ronron-gh/NUCLEO_F401RE_SIMPLE_OSCILLOSCOPE/doc/dev/SWdesign.md

# STM32 簡易オシロスコープ ソフトウェア設計

- [1. 簡易オシロスコープ仕様](#1-簡易オシロスコープ仕様)
- [2. 構成](#2-構成)
  - [2.1. ハードウェアブロック図](#21-ハードウェアブロック図)
  - [2.2. 開発環境](#22-開発環境)
  - [2.3. MCU仕様](#23-mcu仕様)
  - [2.4. MCUのピンアサイン](#24-mcuのピンアサイン)
- [3. サンプリング機能](#3-サンプリング機能)
- [4. 立ち上がりエッジトリガ機能](#4-立ち上がりエッジトリガ機能)
- [5. ディスプレイ表示機能](#5-ディスプレイ表示機能)
- [6. タッチパネル機能](#6-タッチパネル機能)
- [7. 起動画面](#7-起動画面)
  - [7.1. 起動画面データ格納の手順](#71-起動画面データ格納の手順)

## 1. 簡易オシロスコープ仕様

* チャンネル数 : 1ch　(立ち上がりエッジでトリガ可)
* 周波数帯域 : 40kHz
* A/D分解能 : 12bit
* サンプリング周波数 : 200kS/s
* レコード長 : 300サンプル
* 最高入力電圧 : 3.3V (分圧しない場合)

## 2. 構成
### 2.1. ハードウェアブロック図

### 2.2. 開発環境
* 開発用PC ・・・ OS: Windows10 64bit
* 統合開発環境 ・・・ STM32CubeIDE Version:1.8.0

### 2.3. MCU仕様
STM32 Nucleo Board STM32F401RE
* コアアーキテクチャ：ARM 32ビット Cortex-M4
* ピンアウト数：LQFP64
* 最高動作クロック：84MHz
* 内部メモリ：512KB(Flash)、96KB(SRAM)
* タイマー：16ビット多機能タイマx1、汎用タイマ×7
* 通信：SP1×3、I2Sx2、I2C×3、USART×3、USB-OTGx1、SDIOx1
* ADC：12ビットADC x1、10チャンネル
* GPIO数：50(5Vトレラント、一部を除く)
* 電源電圧：1.7~3.6V 

### 2.4. MCUのピンアサイン

■ Nucleo CN5 (digital)

| Pin | MCU pin | Function  | 用途 |
| --- | --- | --- | --- |
| D15 | PB8 | - | MSP2807　T_DO |
| D14 | PB9 | - | MSP2807　T_IRQ |
| GND | - | Ground | MSP2807　GND |
| D13 | PA5 | SPI1_SCK  | MSP2807　SCK |
| D12 | PA6 | SPI1_MISO | MSP2807　SDO(MISO) |
| D11 | PA7 | SPI1_MOSI | MSP2807　SDI(MOSI) |
| D10 | PB6 | - | MSP2807　CS |
| D9  | PC7 | - | MSP2807　DC/RS |
| D8  | PA9 | - | MSP2807　RESET |

■ Nucleo CN6 (power)

| Pin  | MCU pin | Function | 用途 |
| ---- | --- | --- | --- |
| +3V3 | - | 3.3V output | MSP2807　LED (バックライト) |
| +5V  | - | 5V output | MSP2807　VCC |

※バックライトはとりあえず3.3Vに接続しているが、GPIOに接続すればソフトウェアでバックライトをON/OFFできる。  

■ Nucleo CN8 (analog)  

| Pin | MCU pin | Function | 用途 |
| --- | --- | --- | --- |
| A0  | PA0 | ADC1_0 | 入力チャンネル |

■ Nucleo CN9

| Pin | MCU pin | Function | 用途 |
| --- | --- | --- | --- |
| D7  | PA8 | - | MSP2807　T_CLK |
| D6  | PB10 | TIM2_CH3 | テスト用信号(10kHz矩形波) |
| D5  | PB4 | TIM3_CH1 | - |
| D4  | PB5 | - | MSP2807　T_CS |
| D3  | PB3 | TIM2_CH2 | - |
| D2  | PA10 | - | MSP2807　T_DIN |

## 3. サンプリング機能
200kHzでAD変換し、ADデータをRAMに時系列に格納する機能。次の図のように、タイマ、ADC、DMAを連携させることで、ハードウェアのみでそのようなサンプリング機能を実現する。タイマー割り込みをトリガにしてAD変換を起動し、AD変換終了をトリガにしてDMAでADデータをRAMに転送する。

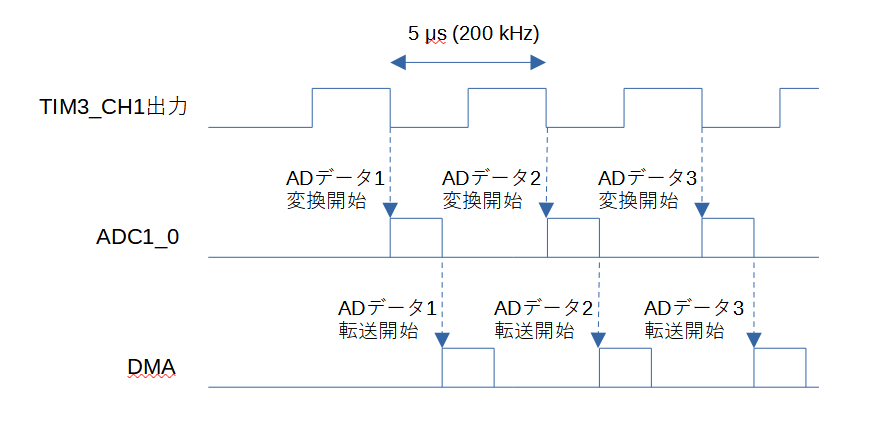
[picture p1: doc/dev/images/サンプリングの仕組み.png]


また、DMAをサーキュラモードにすることで、次の図のように、指定した転送数のメモリ転送を無限に繰り返す（繰り返しにより、先頭データから上書きされていく）。

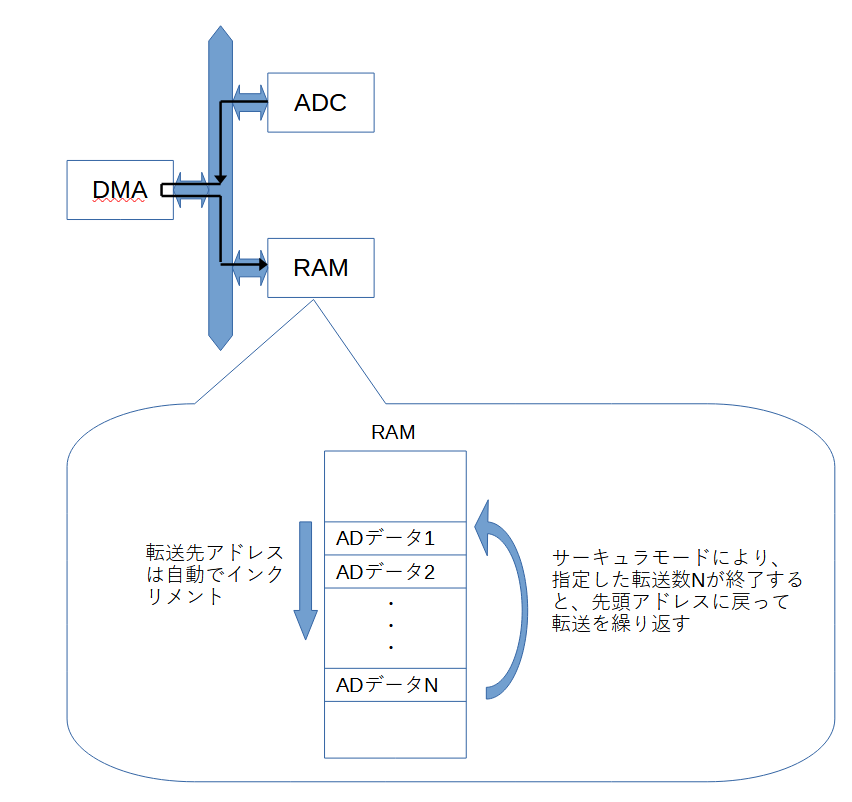
[picture p2: doc/dev/images/サンプリングの仕組み2.png]


## 4. 立ち上がりエッジトリガ機能
入力信号が閾値を超えたらサンプリングを停止する機能。次の図のように、ADCのアナログウォッチドッグ機能（AD変換結果が閾値を超えたら割り込みを発生）とタイマを利用して実現する。

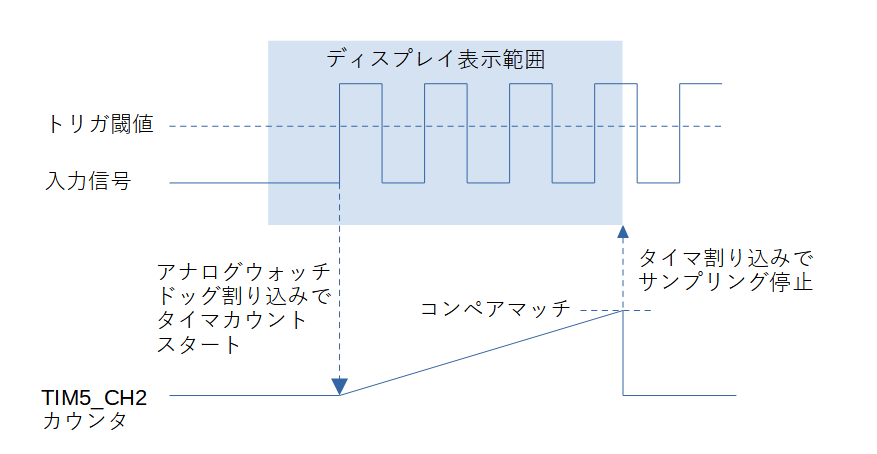
[picture p3: doc/dev/images/トリガの仕組み.png]


## 5. ディスプレイ表示機能
サンプリングデータをリアルタイム（10Hz程度）でディスプレイにグラフ表示する機能。MSP2807のインタフェースはSPIだが、MSP2807のサンプルプログラムをそのまま使うと、ソフトウェアで1ドットずつRGBデータをSPI送信データレジスタに書き込むため、ディスプレイの更新が非常に遅くなる。そのため、全体（320x240）のRGBデータを一旦RAM上で作成し、DMAでSPI送信データレジスタに転送するようにして高速化する。

## 6. タッチパネル機能
MSP2807のタッチパネルでオシロスコープの各種設定を行う機能。  
次の設定が可能。

* ms / div
* V / div
* トリガ機能 ON/OFF

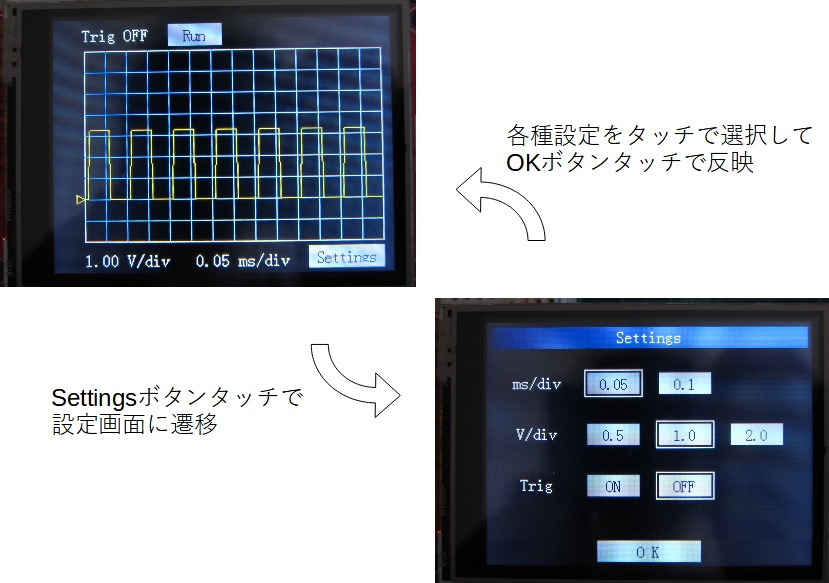
[picture p4: doc/dev/images/タッチパネル概要.jpg]


## 7. 起動画面
電源ON直後から3秒間、起動画面を表示する。起動画面データはフラッシュメモリに格納する（startup_screen.cでconst変数配列としてハードコーディング）。
### 7.1. 起動画面データ格納の手順
① 320x240 [pixel] のビットマップをstartup_screen.bmpというファイル名で作成する。

② 作成したビットマップをScriptフォルダに保存し、Scriptフォルダ内のstartup_screen_converter.py (Pythonスクリプト)を実行すると、output.txtがScriptフォルダ内に作成される。

③ output.txtの配列データをstartup.screen.cの配列 const u16 g_startup_screen[]の初期値としてコピー＆ペーストする。

```c
const u16 g_startup_screen[LCD_BUF_SIZE] = {
    この中にoutput.txt内の配列データをコピペ
}
```
