ronron-gh/NUCLEO_F401RE_SIMPLE_OSCILLOSCOPE/doc/dev/images/175___05/IMG_3227.JPG

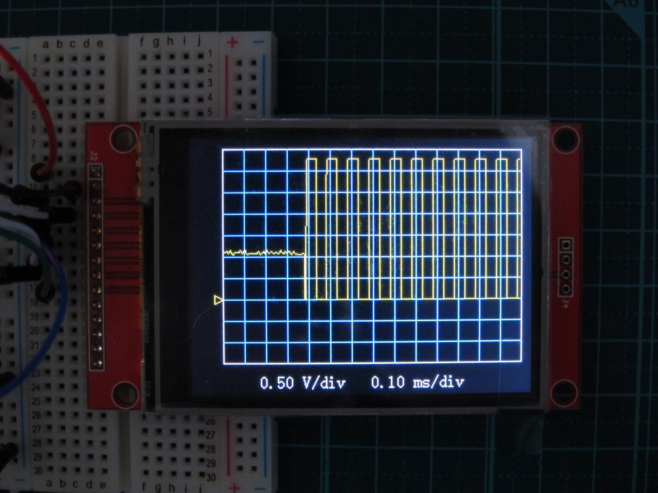
doc/dev/images/175___05/IMG_3227.JPG
