ronron-gh/NUCLEO_F401RE_SIMPLE_OSCILLOSCOPE/doc/dev/images/176___06/IMG_3230.JPG

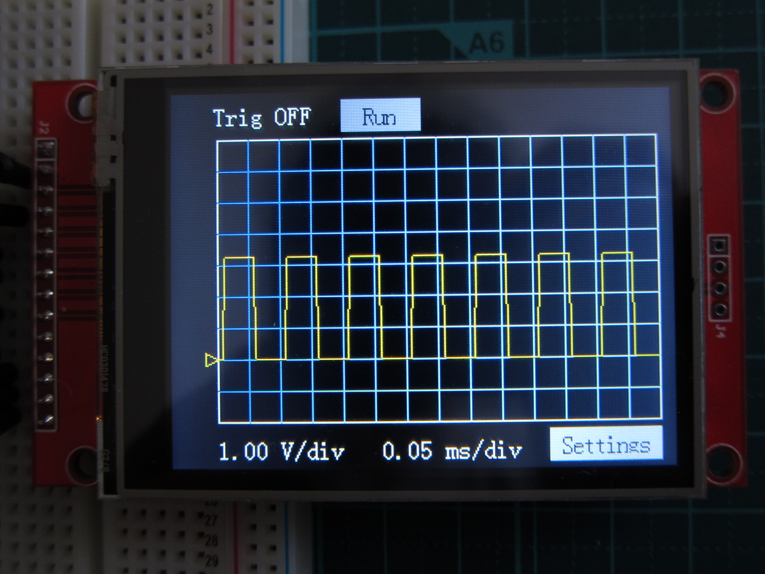
doc/dev/images/176___06/IMG_3230.JPG
