ronron-gh/NUCLEO_F401RE_SIMPLE_OSCILLOSCOPE/doc/dev/images/176___06/IMG_3231.JPG

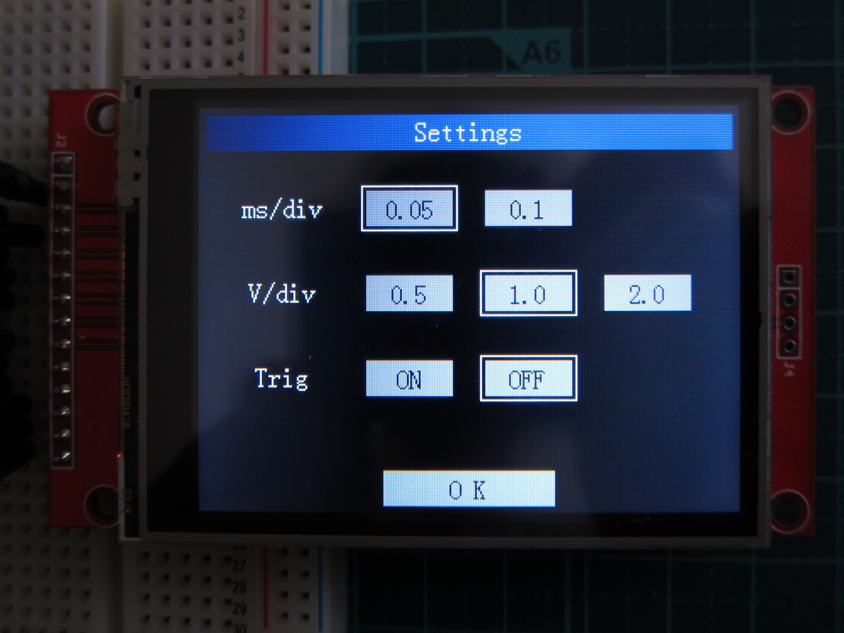
doc/dev/images/176___06/IMG_3231.JPG
