ronron-gh/NUCLEO_F401RE_SIMPLE_OSCILLOSCOPE/Core/Src/main.c

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
/* Includes ------------------------------------------------------------------*/
#include "main.h"

/* USER CODE BEGIN Includes */
#include "stdio.h"
#include "string.h"
#include "math.h"
#include "lcd.h"
#include "lcd2.h"
#include "GUI.h"
#include "Touch.h"
#include "Oscillo.h"
#include "test.h"
/* USER CODE END Includes */

ADC_HandleTypeDef hadc1;
DMA_HandleTypeDef hdma_adc1;

SPI_HandleTypeDef hspi1;
DMA_HandleTypeDef hdma_spi1_tx;

TIM_HandleTypeDef htim2;
TIM_HandleTypeDef htim3;
TIM_HandleTypeDef htim5;

UART_HandleTypeDef huart2;

void SystemClock_Config(void);
static void MX_GPIO_Init(void);
static void MX_USART2_UART_Init(void);
static void MX_SPI1_Init(void);
static void MX_DMA_Init(void);
static void MX_ADC1_Init(void);
static void MX_TIM2_Init(void);
static void MX_TIM3_Init(void);
static void MX_TIM5_Init(void);
/**
  * @brief  The application entry point.
  * @retval int
  */
int main(void)
{
  /* MCU Configuration--------------------------------------------------------*/

  /* Reset of all peripherals, Initializes the Flash interface and the Systick. */
  HAL_Init();

  /* Configure the system clock */
  SystemClock_Config();

  /* Initialize all configured peripherals */
  MX_GPIO_Init();
  MX_USART2_UART_Init();
  MX_DMA_Init();
  MX_SPI1_Init();
  MX_ADC1_Init();
  MX_TIM2_Init();
  MX_TIM3_Init();
  MX_TIM5_Init();
  /* USER CODE BEGIN 2 */
  // !!!Note!!! Modify the auto-generated code to call MX_DMA_Init() before MX_SPI1_Init() in order to use DMA in SPI1

  /* USER CODE END 2 */

  /* Infinite loop */
  /* USER CODE BEGIN WHILE */
  LCD_Init();
  HAL_Delay(3000);
  TP_Init();
  oscillo_init();

  while (1)
  {
#ifndef TOUCH_TEST_MODE
    HAL_Delay(100);
    oscillo_draw(current_view);

#else
	// Touch test
	Touch_Test();
#endif


#if 0	// ADC test
    {
      uint32_t adc_dr;

      HAL_ADC_Start(&hadc1);
	  HAL_ADC_PollForConversion(&hadc1, 1000);
	  adc_dr = HAL_ADC_GetValue(&hadc1);
	  //adc_phy = adc_dr * 3.3 / 4096;
	  printf("adc result: %ld\n", adc_dr);
    }
#endif

#if 0	// LCD test
	  //main_test();
	  	Test_Color();
		Test_FillRec();
		Test_Circle();
		Test_Triangle();
#endif

    /* USER CODE END WHILE */

    /* USER CODE BEGIN 3 */
  }
  /* USER CODE END 3 */
}

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
/* USER CODE BEGIN 4 */
int _write(int file, char *ptr, int len)
{
  int DataIdx;
  for(DataIdx=0; DataIdx<len; DataIdx++)
  {
    ITM_SendChar(*ptr++);
  }
  return len;
}



/* USER CODE END 4 */
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
