ronron-gh/NUCLEO_F401RE_SIMPLE_OSCILLOSCOPE/Core/Inc/main.h

#define LCD_DIRECTION	(1)		// 0:0deg 1:90deg 2:180deg 3:270deg
#define TRUE	(1)
#define FALSE	(0)
#define B1_Pin GPIO_PIN_13
#define B1_GPIO_Port GPIOC
#define B1_EXTI_IRQn EXTI15_10_IRQn
#define USART_TX_Pin GPIO_PIN_2
#define USART_TX_GPIO_Port GPIOA
#define USART_RX_Pin GPIO_PIN_3
#define USART_RX_GPIO_Port GPIOA
#define LCD_RS_Pin GPIO_PIN_7
#define LCD_RS_GPIO_Port GPIOC
#define T_CLK_Pin GPIO_PIN_8
#define T_CLK_GPIO_Port GPIOA
#define LCD_RESET_Pin GPIO_PIN_9
#define LCD_RESET_GPIO_Port GPIOA
#define T_DIN_Pin GPIO_PIN_10
#define T_DIN_GPIO_Port GPIOA
#define TMS_Pin GPIO_PIN_13
#define TMS_GPIO_Port GPIOA
#define TCK_Pin GPIO_PIN_14
#define TCK_GPIO_Port GPIOA
#define SWO_Pin GPIO_PIN_3
#define SWO_GPIO_Port GPIOB
#define T_CS_Pin GPIO_PIN_5
#define T_CS_GPIO_Port GPIOB
#define SPI1_CS_Pin GPIO_PIN_6
#define SPI1_CS_GPIO_Port GPIOB
#define T_DO_Pin GPIO_PIN_8
#define T_DO_GPIO_Port GPIOB
#define T_IRQ_Pin GPIO_PIN_9
#define T_IRQ_GPIO_Port GPIOB
#define T_IRQ_EXTI_IRQn EXTI9_5_IRQn
