ronron-gh/NUCLEO_F401RE_SIMPLE_OSCILLOSCOPE/Lcd/lcd.h

//////////////////////////////////////////////////////////////////////////////////	 

















//All rights reserved
/****************************************************************************************************
























**************************************************************************************************/		
 /* @attention
  *
  * THE PRESENT FIRMWARE WHICH IS FOR GUIDANCE ONLY AIMS AT PROVIDING CUSTOMERS
  * WITH CODING INFORMATION REGARDING THEIR PRODUCTS IN ORDER FOR THEM TO SAVE
  * TIME. AS A RESULT, QD electronic SHALL NOT BE HELD LIABLE FOR ANY
  * DIRECT, INDIRECT OR CONSEQUENTIAL DAMAGES WITH RESPECT TO ANY CLAIMS ARISING
  * FROM THE CONTENT OF SUCH FIRMWARE AND/OR THE USE MADE BY CUSTOMERS OF THE
  * CODING INFORMATION CONTAINED HEREIN IN CONNECTION WITH THEIR PRODUCTS.
**************************************************************************************************/	
#ifndef __LCD_H
#define __LCD_H		
//#include "sys.h"
#include "stdlib.h"
#include "main.h"



typedef struct  
{										    
	u16 width;
	u16 height;
	u16 id;				//LCD ID
	u8  dir;
	u16	 wramcmd;
	u16  setxcmd;
	u16  setycmd;
}_lcd_dev; 	


extern _lcd_dev lcddev;

#define USE_HORIZONTAL  	 0

//////////////////////////////////////////////////////////////////////////////////	  

#define LCD_W 240
#define LCD_H 320


extern u16  POINT_COLOR;
extern u16  BACK_COLOR;

////////////////////////////////////////////////////////////////////

#if 0
#define LED  13
#define CS   15
#define RS   14
#define RST  12


#define	LCD_LED PBout(LED)
#define LCD_CS  PBout(CS)
#define LCD_RS  PBout(RS)
#define LCD_RST PBout(RST)



#define	LCD_CS_SET  LCD_CS=1
#define	LCD_RS_SET	LCD_RS=1
#define	LCD_RST_SET	LCD_RST=1

 							    
#define	LCD_CS_CLR  LCD_CS=0
#define	LCD_RS_CLR	LCD_RS=0
#define	LCD_RST_CLR	LCD_RST=0
#endif

#define	LCD_CS_SET  HAL_GPIO_WritePin(SPI1_CS_GPIO_Port, SPI1_CS_Pin, GPIO_PIN_SET)
#define	LCD_RS_SET	HAL_GPIO_WritePin(LCD_RS_GPIO_Port, LCD_RS_Pin, GPIO_PIN_SET)
#define	LCD_RST_SET	HAL_GPIO_WritePin(LCD_RESET_GPIO_Port, LCD_RESET_Pin, GPIO_PIN_SET)

#define	LCD_CS_CLR  HAL_GPIO_WritePin(SPI1_CS_GPIO_Port, SPI1_CS_Pin, GPIO_PIN_RESET)
#define	LCD_RS_CLR	HAL_GPIO_WritePin(LCD_RS_GPIO_Port, LCD_RS_Pin, GPIO_PIN_RESET)
#define	LCD_RST_CLR	HAL_GPIO_WritePin(LCD_RESET_GPIO_Port, LCD_RESET_Pin, GPIO_PIN_RESET)



#define WHITE       0xFFFF
#define BLACK      	0x0000	  
#define BLUE       	0x001F  
#define BRED        0XF81F
#define GRED 			 	0XFFE0
#define GBLUE			 	0X07FF
#define RED         0xF800
#define MAGENTA     0xF81F
#define GREEN       0x07E0
#define CYAN        0x7FFF
#define YELLOW      0xFFE0
#define BROWN 			0XBC40
#define BRRED 			0XFC07
#define GRAY  			0X8430


#define DARKBLUE      	 0X01CF
#define LIGHTBLUE      	 0X7D7C
#define GRAYBLUE       	 0X5458

 
#define LIGHTGREEN     	0X841F
#define LIGHTGRAY     0XEF5B
#define LGRAY 			 		0XC618

#define LGRAYBLUE      	0XA651
#define LBBLUE          0X2B12
	    															  
void LCD_Init(void);
void LCD_DisplayOn(void);
void LCD_DisplayOff(void);
void LCD_Clear(u16 Color);
void LCD_DrawPicture(u16* picture);
void LCD_SetCursor(u16 Xpos, u16 Ypos);
void LCD_DrawPoint(u16 x,u16 y);
u16  LCD_ReadPoint(u16 x,u16 y);
void LCD_DrawLine(u16 x1, u16 y1, u16 x2, u16 y2);
void LCD_DrawRectangle(u16 x1, u16 y1, u16 x2, u16 y2);		   
void LCD_SetWindows(u16 xStar, u16 yStar,u16 xEnd,u16 yEnd);

u16 LCD_RD_DATA(void);
void LCD_WriteReg(u8 LCD_Reg, u16 LCD_RegValue);
void LCD_WR_DATA(u8 data);
u16 LCD_ReadReg(u8 LCD_Reg);
void LCD_WriteRAM_Prepare(void);
void LCD_WriteRAM(u16 RGB_Code);
u16 LCD_ReadRAM(void);		   
u16 LCD_BGR2RGB(u16 c);
void LCD_SetParam(void);
void Lcd_WriteData_16Bit(u16 Data);
void LCD_direction(u8 direction );



/*
#if LCD_USE8BIT_MODEL==1
	#define LCD_WR_DATA(data){\
	LCD_RS_SET;\
	LCD_CS_CLR;\
	DATAOUT(data);\
	LCD_WR_CLR;\
	LCD_WR_SET;\
	DATAOUT(data<<8);\
	LCD_WR_CLR;\
	LCD_WR_SET;\
	LCD_CS_SET;\
	}
	#else
	#define LCD_WR_DATA(data){\
	LCD_RS_SET;\
	LCD_CS_CLR;\
	DATAOUT(data);\
	LCD_WR_CLR;\
	LCD_WR_SET;\
	LCD_CS_SET;\
	} 	
#endif
*/
				  		 
#endif  
	 
	 
