ronron-gh/NUCLEO_F401RE_SIMPLE_OSCILLOSCOPE/Core/Inc/type.h

/*
 * type.h
 *
 *  Created on: 2022/05/24
 *      Author: motoh
 */

#ifndef INC_TYPE_H_
#define INC_TYPE_H_

typedef int32_t   s32;
typedef int16_t   s16;
typedef int8_t    s8;
typedef uint32_t  u32;
typedef uint16_t  u16;
typedef uint8_t   u8;

#endif /* INC_TYPE_H_ */
