ronron-gh/NUCLEO_F401RE_SIMPLE_OSCILLOSCOPE/(commit log)

2022-05-29 デバッグコードを整理。コメントを修正。
2022-05-29 READMEを修正
2022-06-01 gitignoreを追加
2022-06-01 コメントを修正
2022-06-12 自動生成コードに関する注意事項を追記。
2022-06-18 液晶のタッチ操作により設定変更する機能を追加。オシロスコープのアプリケーション部分のコードをOscillo.cに集約。
2022-06-18 READMEにバージョン履歴を追加
2022-06-19 バージョン履歴を修正
2022-06-21 FW設計書を更新
2022-08-23 ・AD変換結果に分圧比を掛ける処理を追加。 ・#define TOUCH_TEST_MODE を有効化してビルドするとTFT液晶のテストモードを起動できるようにした。 ・#define LCD_DIRECTION の値を変えることで液晶表示の上下を反転できるようにした。
2022-09-01 起動画面を追加。分圧比に合わせてanalog watchdogの閾値を修正。
